mw46d/robot_arm/README.md

SO-robot-arm
============

Arduino sketch for our Robot Arm
