mw46d/robot_arm/Unpack-Run.odt

Startup/Shutdown Steps

1. Unpack
  can be done beforehand, but preferably close to the competition location.
  1. Remove the cable binder from the gripper
  2. Remove the transport braces around the base
  3. Unhook the springs, add the counter weight and reinstall the springs
  4. Make sure the little felt `oscillation damper' is in the base.
  5. Connect the red battery plug, the first LEDs should turn on (2 red, 2 green)
2. Startup
  1. Position the base EXACTLY in the robot square.
  2. Turn on the power switch, LEDs on the Maestro & Arduino should start blinking
  3. Start the laptop (Linux)
  4. Connect the USB cable from the laptop → Arduino
  5. Start the Arduino IDE on the Laptop
  6. Open (↑) the robot_arm sketch
  7. Make sure the IDE found the right USB port (Tools → Serial Port → /dev/ttyACM0 or 1, 2, ...)
  8. Upload (→) the sketch (This might fail once or twice, simply try again after checking the port)
  9. Open the Serial Monitor (Tools → Serial Monitor)
  10. The Arduino should now display a line in the serial monitor
3. Run
  1. The serial monitor window should ask to input an `s' character
  2. → s , Enter or the Send button will send the character!
  3. The arm should start moving
  4. Input e or w for the position of the bonus box. Don't forget the Enter/Send
  5. The next sent character will start the run. Type a character but wait with the Enter/Send for the command from the Event Supervisor
  6. The arm should run it's pre-programmed steps.
  7. If you have to stop the run, send a p character. That will cause the arm to stop the running sequence and go back into it's park position.
  8. The monitor will output some lines and at the end it will output the time it took to run the complete sequence.
4. Shutdown
  1. After the run, the monitor will ask for an character to go back into the park position.
  2. Send any character
  3. The arm goes to park.
  4. Close the IDE
  5. Disconnect the USB cable
  6. Shut down the laptop
  7. Turn the power switch OFF
5. Packing
  1. Disconnect the red battery plug
  2. Unhook the springs, remove the counter weight, replace the springs
  3. Install the transport braces, the one parallel to the arm need sto be the lower one!
  4. Fasten the gripper with the cable binder
