mw46d/robot_arm/Robot1.pdf

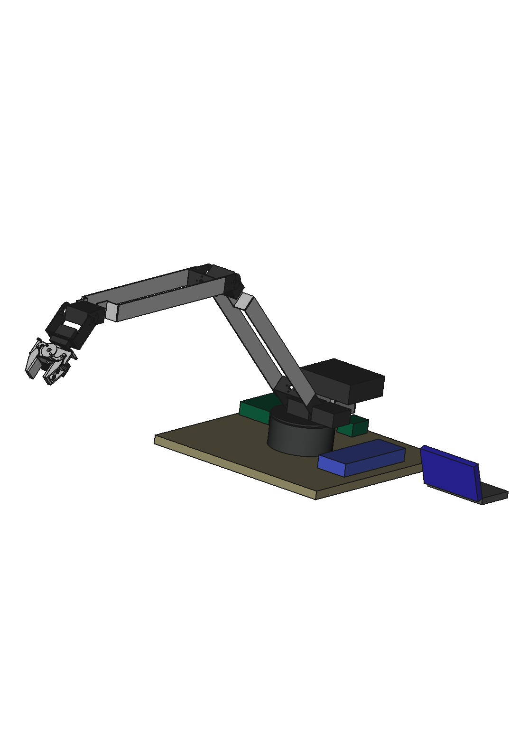
[picture p1: page 1]
