mw46d/robot_arm/Robot2.pdf

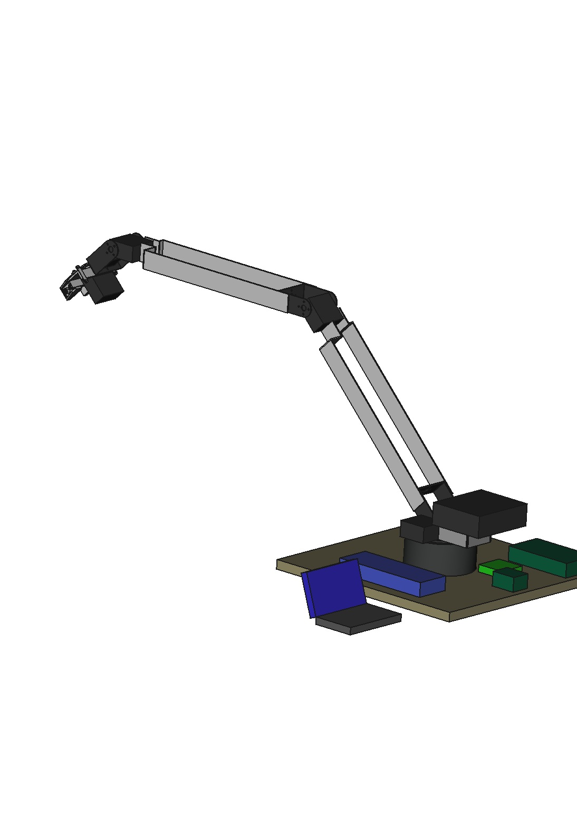
[picture p2: page 1]
