mw46d/robot_arm/ComponentList.ods

 |  | Robot Arm: Component List
 |  | Team: Millennium – Gold
Number | Name | Vendor/Source | Energy Source | Property 1 | Property 2 | Count | Notes
1 | Felt Base | OSH | n/a | Width: 25.4mm | Length: 290 mm | 2 | stabilize base
2 | Felt Base | OSH | n/a | Width: 25.4 mm | Length: 240 mm | 2 | stabilize base
3 | Base Plate | Scrap | n/a | Width: 300 mm | Length: 300 mm | 1 | particle board
4 | Milk Cap | Raily's | n/a | red | Diameter: 39 mm | 1 | temp hold for TT ball
5 | Battery | Hobby King | Self | Voltage: 7.4 V | Rated Charge: 5000 mAh | 1 | LiPoly
6 | Universal Battery Elimination Circuit (UBEC) | Hobby King | #5 | Vout : 6 V | Imax : 8A | 1 | condition input voltage for servos & controllers
7 | Maestro Servo Controller | pololu.com | #8 | 12 Channel | Weight: 4.2 g | 1 | Pulse Width Modulation (PWM) control servos
8 | Arduino Mega ADK | adafruit.com | #6 | Width:53.63 mm | Length:101.98 mm | 1 | MicroController which runs the program for the arm
9 | cable | pololu.com | n/a | Length: ca. 330 mm | different colors | 7 | connections between #6, #7, #8
10 | Base Rotate Kit | lynxmotion.com | n/a | Top Diameter: 93.7 mm | Height: 47.7 mm | 1 | Modified to fit #11
11 | Servo GWS S125 1/2T 2BB | pololu.com | #6 | Stall torque @ 6V: 7.6 kg.cm | Weight: 50 g | 1 | Servo 0, rcan rotate almost 360
12 | Aluminum Dual Servo Bracket | lynxmotion.com | n/a | Material: Aluminum | Weight: 45.6 g | 1 | Servo 1a,1b
13 | Servo Power HD 1501MG | valuehobby.com | #6 | Stall torque @ 6V: 17.0 kg.cm | Weight: 60 g | 3 | Servo 1a, 1b, 2
14 | Long "C" Servo Bracket with Ball Bearings | lynxmotion.com | n/a | Material: Aluminum | Weight: 32 g | 2 | Extra holes to fasten aluminum bars
15 | Counter Weight Holder | OSH/home bend | n/a | Material: Aluminum | Width: 25.4 mm | 1 | Holds the diving weight
16 | Diving Weight | Sports Authority | n/a | Weight: 1368 g | Length: 90 mm | 1 | Counter Weight
17 | Load Balancing Spring | lynxmotion.com | n/a | Length: 50.8 mm | Load Rating: 1646 g | 2
18 | Cable Harness | pololu.com/home | n/a | 2 power leads | 5 control leads | 1 | Extension/connections for servos 1-5
19 | Upper Arm Profile 1 | OSH/home bend | n/a | Material: Aluminum | Width: 25.4 mm | 1
20 | Upper Arm Profile 2 | OSH/home bend | n/a | Material: Aluminum | Width: 25.4 mm | 1
21 | Multi-Purpose Servo Bracket | lynxmotion.com | n/a | Material: Aluminum | Weight: 45.6 g | 2 | Servo 2, 3
22 | Lower Arm Profile 1 | OSH/home bend | n/a | Material: Aluminum | Width: 25.4 mm | 1
23 | Lower Arm Profile 2 | OSH/home bend | n/a | Material: Aluminum | Width: 25.4 mm | 1
24 | Servo Towerpro SG5010 | valuehobby.com | #6 | Stall torque @ 6V: 4.5 kg.cm | Weight: 38 g | 2 | Servo 3, 5
25 | Micro-Servo Rotate Bracket | lynxmotion.com | n/a | Material: Aluminum | Weight: 22.8 g | 1
26 | Servo Power HD 1711MG | valuehobby.com | #6 | Stall torque @ 6V: 3.5 kg.cm | Weight: 17.5 g | 1 | Servo 4
27 | Little Grip Kit | lynxmotion.com | n/a | Material: ABS | Weight: 27.4 g | 1
28 | Ball Extensions | Staples/home bend | n/a | Material: Steel | Wire Dia: 1.25 mm | 2
29 | USB cable | Staples | n/a | Color: black | Lenght: ca 2000 mm | 1 | Connect Laptop to Arduino board
30 | Laptop | Lenovo | internal | OS: Linux | Screen: 391 mm | 1 | Control/Input box – Running Arduino IDE
