mw46d/robot_arm/Base.FCStd

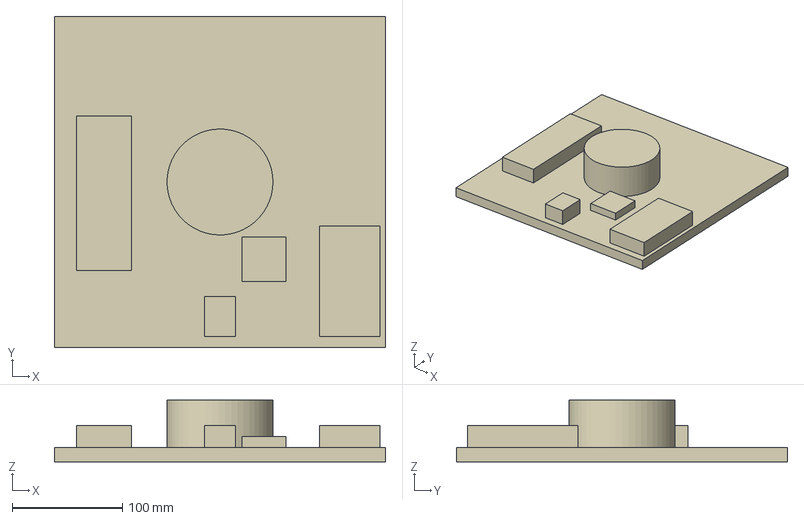
[picture p3: CAD file, 2013-03-02]
Base.FCStd
300.0 x 300.0 x 56.0 mm
