mw46d/robot_arm/Shoulder.FCStd

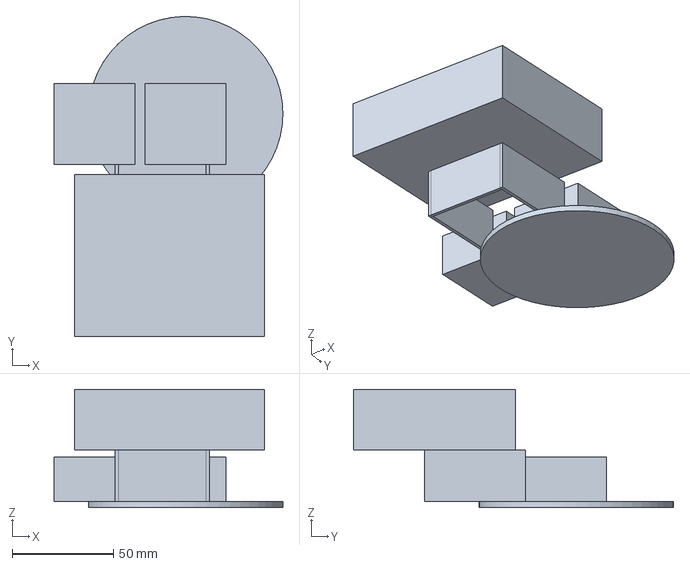
[picture p4: CAD file, 2013-03-02]
Shoulder.FCStd
113.0 x 158.0 x 58.4 mm
