mw46d/robot_arm/Gripper.FCStd

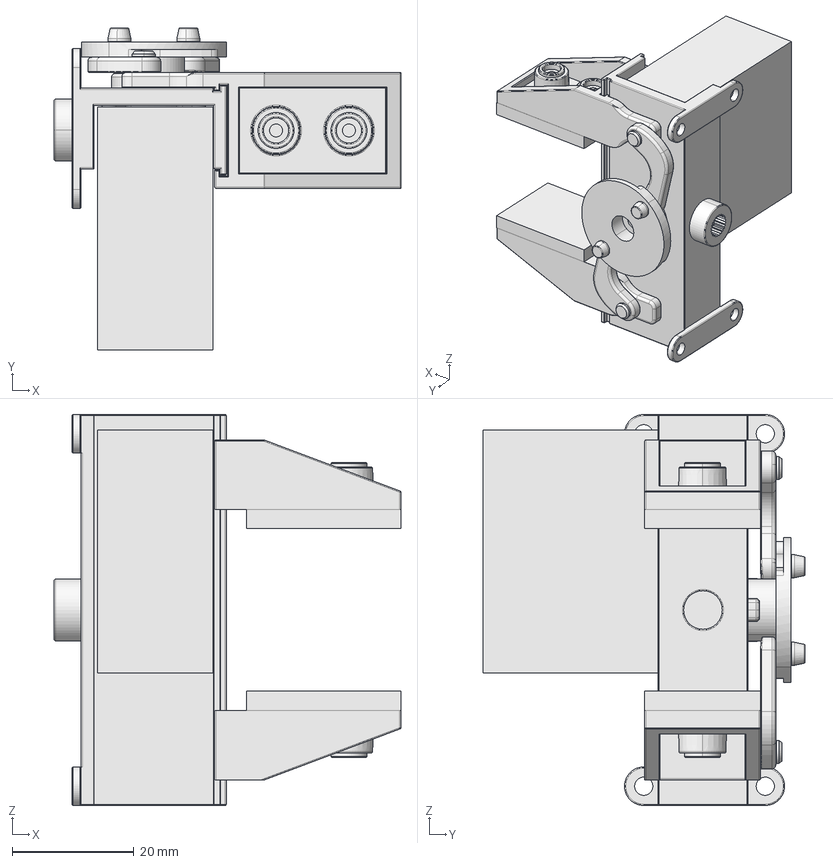
[picture p5: CAD file, 2013-03-02]
Gripper.FCStd
57.1 x 53.0 x 64.4 mm
