mw46d/robot_arm/UpperArm.FCStd

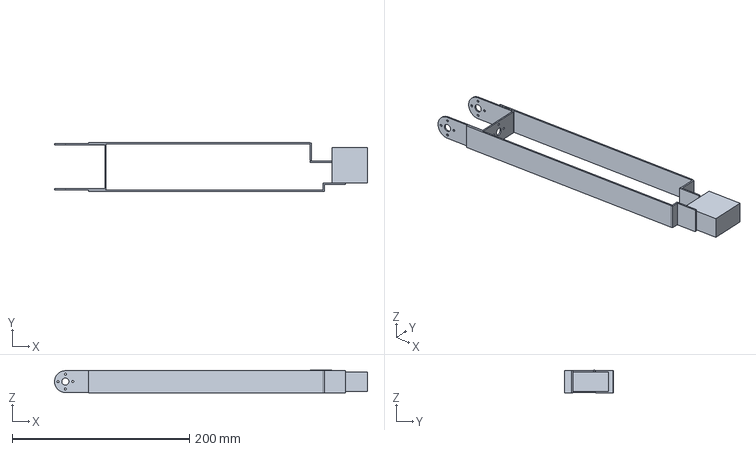
[picture p6: CAD file, 2013-03-02]
UpperArm.FCStd
353.3 x 55.7 x 25.8 mm
