mw46d/robot_arm/Robot.FCStd

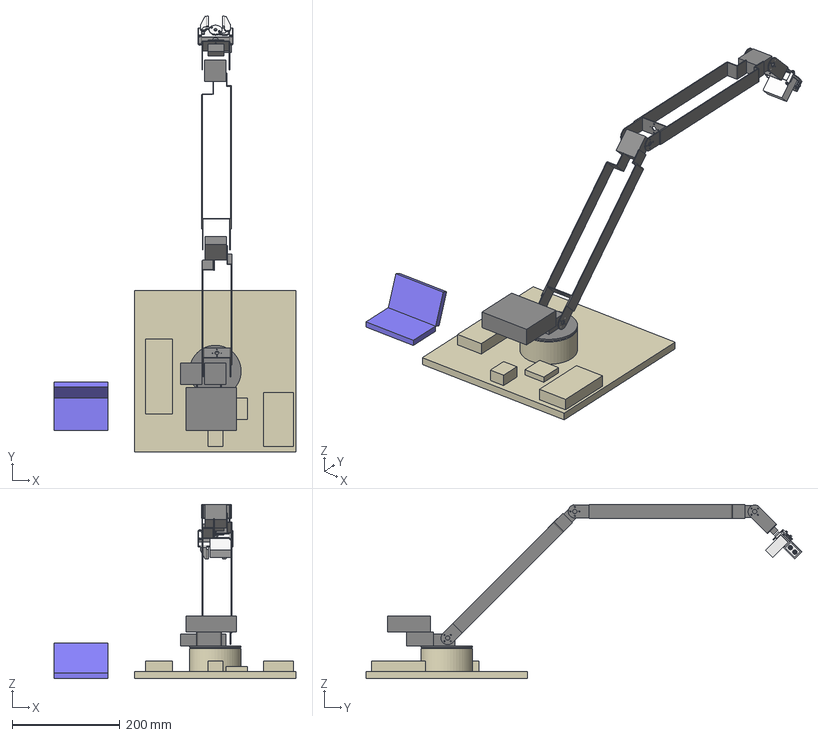
[picture p7: CAD file, 2013-03-02]
Robot.FCStd
450.0 x 810.0 x 324.1 mm
Upper Arm
Shoulder
Lower Arm
Base
Gripper
Wrist
Laptop
