mw46d/robot_arm/Wrist.FCStd

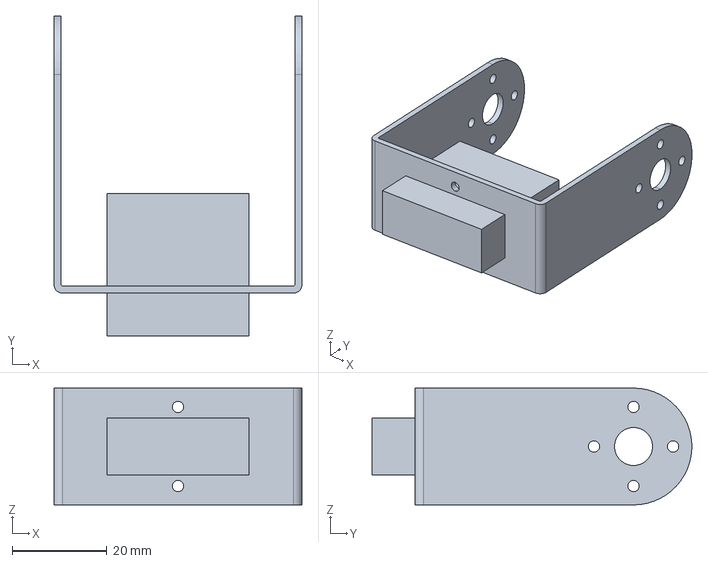
[picture p8: CAD file, 2013-03-02]
Wrist.FCStd
52.2 x 67.3 x 24.6 mm
