mw46d/robot_arm/Laptop.FCStd

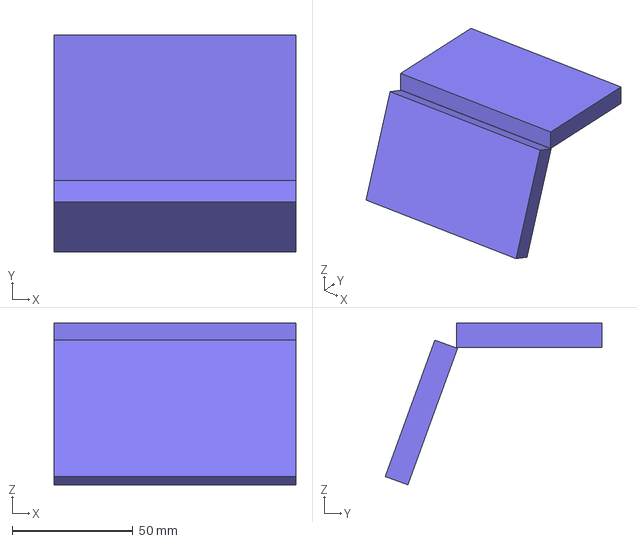
[picture p9: CAD file, 2013-03-02]
Laptop.FCStd
100.0 x 89.5 x 66.8 mm
