mw46d/robot_arm/(list of files, cad)

Other CAD files:
LowerArm.FCStd
