mw46d/robot_arm/Operation Description.odt

Robot Arm: Operation Description

Team: Millennium – Gold

The robot arm is designed to run a predetermined sequence of steps after the start. The sequence was determined in test runs with the Maestro Controller Board by carefully moving each servo to it's target position and recording the timing values.

In it's park position, the robot arm expects some character input on it's USB connection:

s – to bring the arm out of it's parking position

e or w – to communicate the location of the bonus box

s – to start the timed run

During the run, sending a p character will cause the arm to abort the run and move back to the parking position.

After the run, any character will send the arm back to it's parking position.
