mw46d/robot_arm/(commit log)

2013-02-15 Some fixes and a printf implenentation
    [robot_arm.ino]
2013-03-02 The funnel did not work
    [robot_arm.ino]
2013-03-02 Support files
    [Base.FCStd, ComponentList.ods, Gripper.FCStd, Laptop.FCStd, LowerArm.FCStd, Robot.FCStd, Shoulder.FCStd, UpperArm.FCStd]
